4keles/esp32-fft-visualizer/core/src/fv_tables_gen.cpp

// ÜRETİLMİŞ DOSYA — elle düzenlemeyin. Kaynak: tools/gen_tables.cpp
// Yeniden üretmek: build/gen_tables > core/src/fv_tables_gen.cpp
#include "fv_tables.h"

namespace fv {
namespace tab {

const int16_t hann1024[FFT_N / 2 + 1] = {
    0, 0, 1, 3, 5, 8, 11, 15, 20, 25, 31, 37,
    44, 52, 60, 69, 79, 89, 100, 111, 123, 136, 149, 163,
    177, 192, 208, 224, 241, 259, 277, 296, 315, 335, 355, 376,
    398, 420, 443, 467, 491, 516, 541, 567, 593, 621, 648, 677,
    705, 735, 765, 796, 827, 859, 891, 924, 958, 992, 1027, 1062,
    1098, 1134, 1171, 1209, 1247, 1286, 1325, 1365, 1406, 1447, 1488, 1530,
    1573, 1616, 1660, 1704, 1749, 1795, 1841, 1887, 1935, 1982, 2030, 2079,
    2128, 2178, 2229, 2280, 2331, 2383, 2435, 2488, 2542, 2596, 2651, 2706,
    2761, 2817, 2874, 2931, 2989, 3047, 3105, 3165, 3224, 3284, 3345, 3406,
    3468, 3530, 3592, 3655, 3719, 3783, 3847, 3912, 3978, 4044, 4110, 4177,
    4244, 4312, 4380, 4449, 4518, 4587, 4657, 4728, 4799, 4870, 4942, 5014,
    5087, 5160, 5233, 5307, 5381, 5456, 5531, 5606, 5682, 5759, 5835, 5913,
    5990, 6068, 6146, 6225, 6304, 6383, 6463, 6543, 6624, 6705, 6786, 6868,
    6950, 7032, 7115, 7198, 7282, 7365, 7449, 7534, 7619, 7704, 7789, 7875,
    7961, 8047, 8134, 8221, 8308, 8396, 8484, 8572, 8661, 8749, 8839, 8928,
    9018, 9108, 9198, 9288, 9379, 9470, 9561, 9653, 9745, 9837, 9929, 10021,
    10114, 10207, 10300, 10394, 10487, 10581, 10676, 10770, 10864, 10959, 11054, 11149,
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
    70, 69, 68, 66, 65, 64, 63, 61, 60, 59, 58, 57,
    55, 54, 53, 52, 51, 50, 49, 48, 47, 46, 45, 44,
    44, 43, 42, 41, 40, 39, 38, 38, 37, 36, 35, 35,
    34, 33, 33, 32, 31, 31, 30, 29, 29, 28, 28, 27,
    26, 26, 25, 25, 24, 24, 23, 23,
};

}  // namespace tab
}  // namespace fv
